AmaRamaa/GearBox-Kosova-2027-VR/version-c-inline-4-improved/print/one-plate-70pct/checks/gear_report.txt

pinion 14T - 42T (x6)      cd  24.89  teeth reach 1.78 mm  tip-root gap 0.22  interference 0.000  backlash 0.40-0.40 mm  teeth in contact 1-2 (avg 1.88)  OK
shifted 14T - 40T (x3)     cd  24.89  teeth reach 1.48 mm  tip-root gap 0.22  interference 0.000  backlash 0.33-0.33 mm  teeth in contact 1-2 (avg 1.46)  OK
ALL GEAR MESHES OK
