AmaRamaa/GearBox-Kosova-2027-VR/version-c-inline-4-improved/print/beds_overview.png

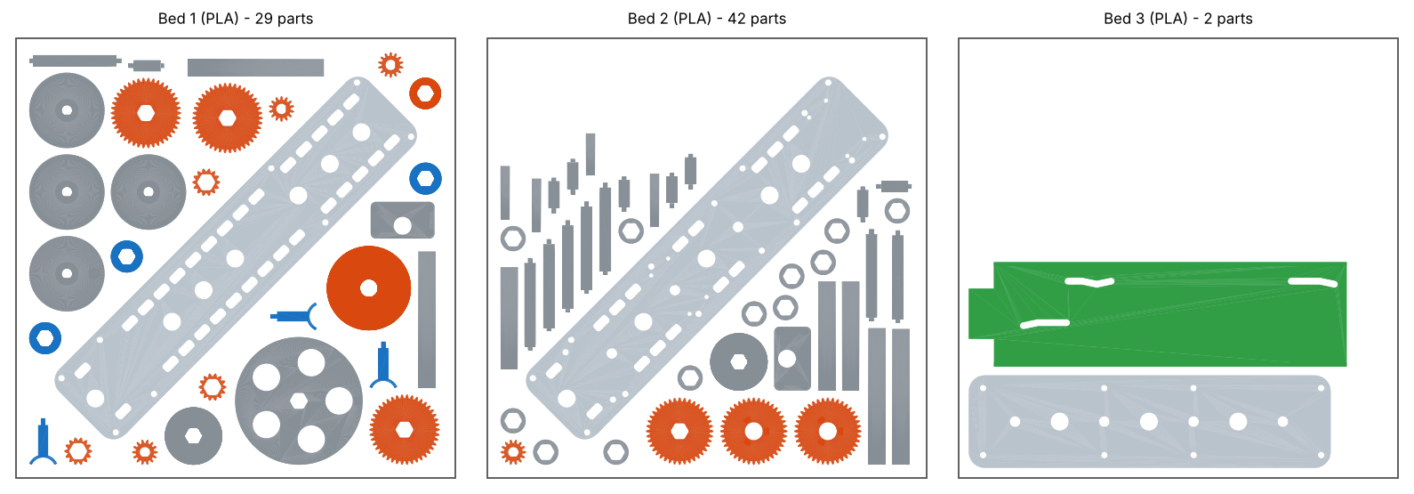
version-c-inline-4-improved/print/beds_overview.png
