AmaRamaa/GearBox-Kosova-2027-VR/version-c-inline-4-improved/print/one-plate-70pct/guide/parts_sheet.png

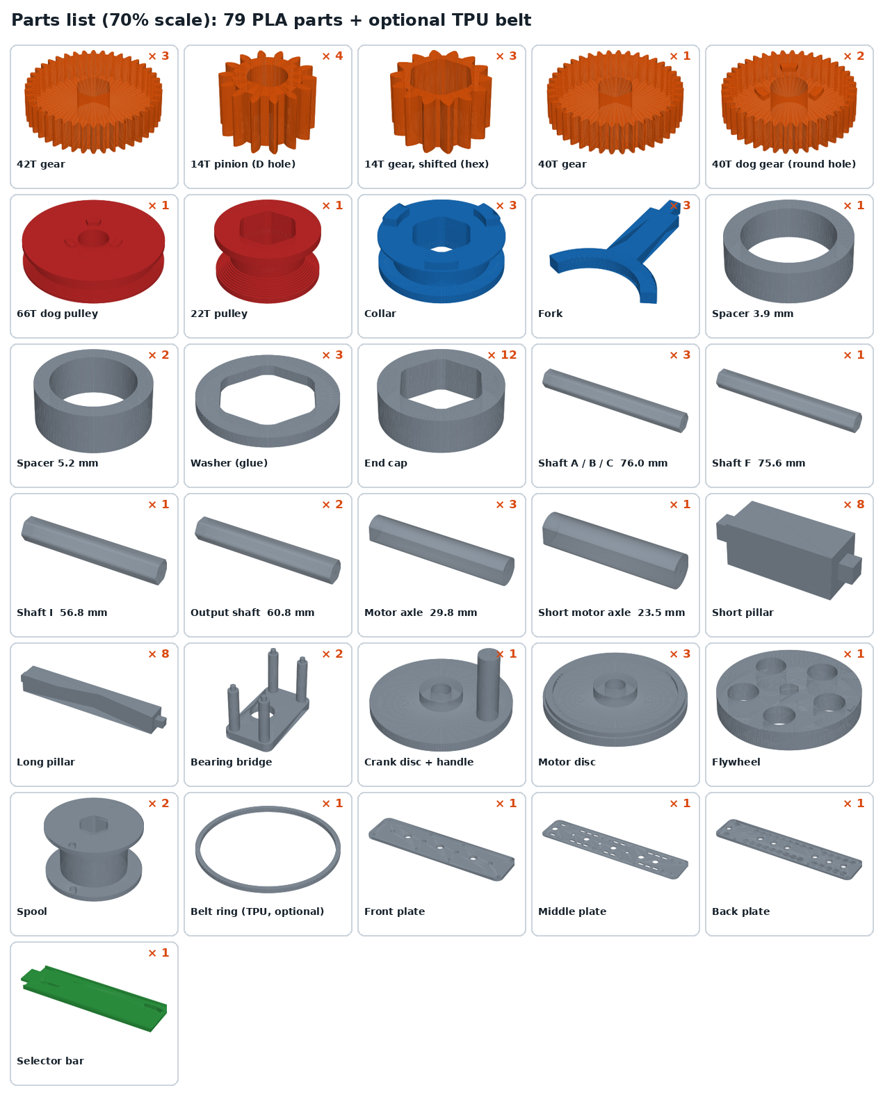
version-c-inline-4-improved/print/one-plate-70pct/guide/parts_sheet.png
