AmaRamaa/GearBox-Kosova-2027-VR/version-c-inline-4-improved/print/bed_TPU_belt.3mf

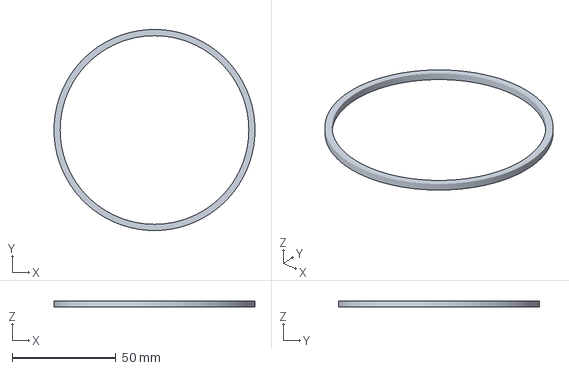
[picture p3: CAD file, 2026-10-18]
version-c-inline-4-improved/print/bed_TPU_belt.3mf
96.7 x 96.7 x 3.00 mm
