AmaRamaa/GearBox-Kosova-2027-VR/version-c-inline-4-improved/print/one-plate-70pct/bed_one_plate_PLA_70pct.3mf

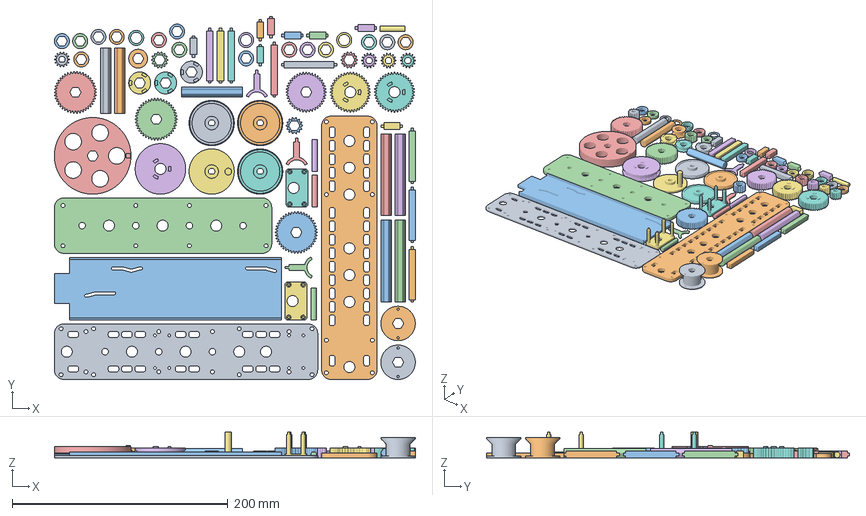
[picture p4: CAD file, 2026-10-18]
version-c-inline-4-improved/print/one-plate-70pct/bed_one_plate_PLA_70pct.3mf
335.3 x 336.9 x 23.8 mm
plate_middle
plate_back
selector_bar
plate_front
flywheel
pulley_66T_dog
crank_disc_handle
crank_disc_1
crank_disc_2
crank_disc_3
gear_42T_1
gear_42T_2
gear_42T_3
gear_40T
gear_40T_dog_1
gear_40T_dog_2
spool_1
spool_2
shaft_ABC_1
shaft_ABC_2
shaft_ABC_3
shaft_F
bridge_1
bridge_2
shaft_O2_O3_1
shaft_O2_O3_2
shaft_I
fork_1
fork_2
fork_3
collar_1
collar_2
collar_3
pillar_back_1
pillar_back_2
pillar_back_3
pillar_back_4
pillar_back_5
pillar_back_6
pillar_back_7
pillar_back_8
pulley_22T
gear_14T_shifted_1
gear_14T_shifted_2
gear_14T_shifted_3
pinion_14T_1
pinion_14T_2
pinion_14T_3
pinion_14T_4
end_cap_1
end_cap_2
end_cap_3
end_cap_4
end_cap_5
end_cap_6
end_cap_7
end_cap_8
end_cap_9
end_cap_10
end_cap_11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
