AmaRamaa/GearBox-Kosova-2027-VR/version-c-inline-4-improved/print/stl/gear_40T_dog.stl

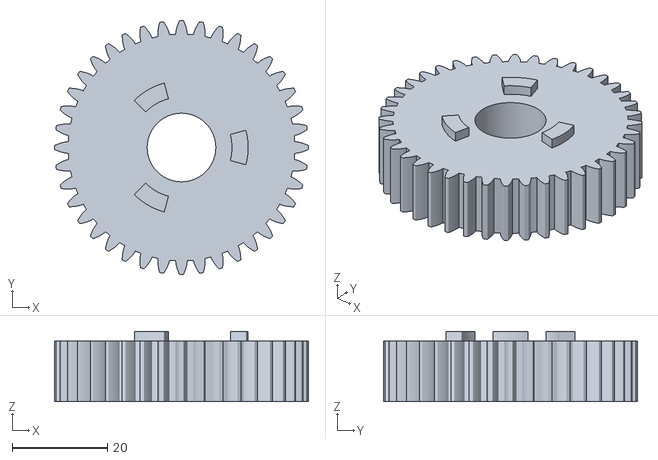
[picture p5: CAD file, 2026-10-18]
version-c-inline-4-improved/print/stl/gear_40T_dog.stl
53.3 x 53.3 x 14.7
