AmaRamaa/GearBox-Kosova-2027-VR/version-c-inline-4-improved/print/bed_2_PLA.3mf

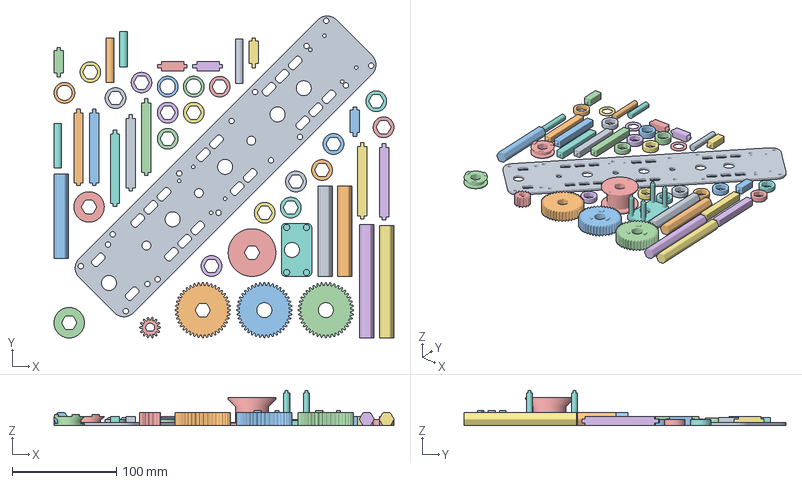
[picture p6: CAD file, 2026-10-18]
version-c-inline-4-improved/print/bed_2_PLA.3mf
326.0 x 308.7 x 33.9 mm
plate_middle
gear_40T
gear_40T_dog_1
gear_40T_dog_2
spool_2
shaft_ABC_3
shaft_F
bridge_2
shaft_O2_O3_1
shaft_O2_O3_2
shaft_I
collar_2
collar_3
pillar_back_2
pillar_back_3
pillar_back_4
pillar_back_5
pillar_back_6
pillar_back_7
pillar_back_8
pinion_14T_4
end_cap_1
end_cap_2
end_cap_3
end_cap_4
end_cap_5
end_cap_6
end_cap_7
end_cap_8
end_cap_9
end_cap_10
end_cap_11
end_cap_12
spacer_A
spacer_O2_O3_1
spacer_O2_O3_2
washer_1
washer_2
washer_3
axle_M1_M3_1
axle_M1_M3_2
axle_M1_M3_3
pillar_front_4
pillar_front_5
pillar_front_6
pillar_front_7
pillar_front_8
axle_M4
