AmaRamaa/GearBox-Kosova-2027-VR/version-c-inline-4-improved/print/one-plate-70pct/bed_TPU_belt_70pct.3mf

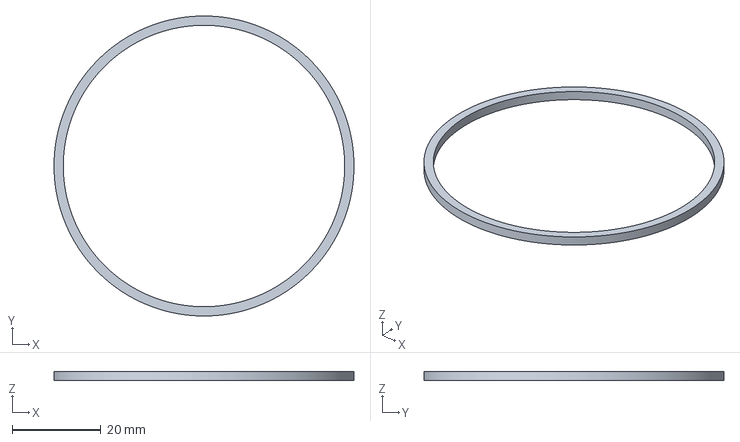
[picture p7: CAD file, 2026-10-18]
version-c-inline-4-improved/print/one-plate-70pct/bed_TPU_belt_70pct.3mf
67.7 x 67.7 x 2.10 mm
