AmaRamaa/GearBox-Kosova-2027-VR/version-c-inline-4-improved/print/one-plate-70pct/stl/selector_bar.stl

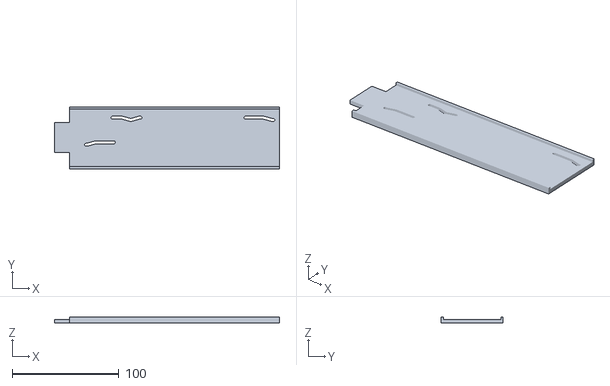
[picture p8: CAD file, 2026-10-18]
version-c-inline-4-improved/print/one-plate-70pct/stl/selector_bar.stl
210.7 x 58.1 x 5.60
