AmaRamaa/GearBox-Kosova-2027-VR/version-c-inline-4-improved/print/stl/pulley_66T_dog.stl

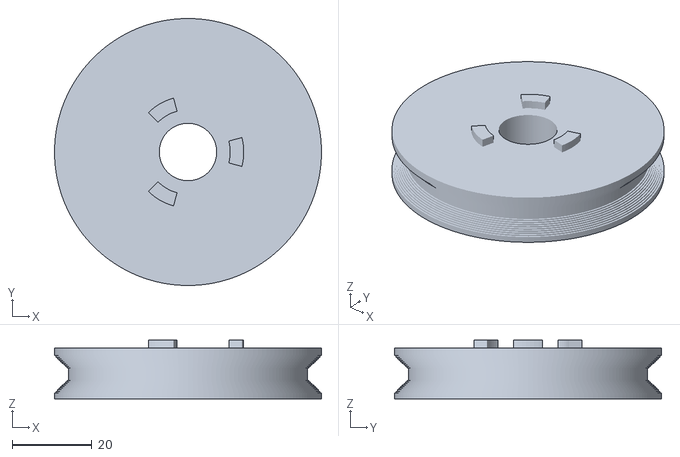
[picture p9: CAD file, 2026-10-18]
version-c-inline-4-improved/print/stl/pulley_66T_dog.stl
67.0 x 67.0 x 14.7
