AmaRamaa/GearBox-Kosova-2027-VR/version-c-inline-4-improved/print/bed_3_PLA.3mf

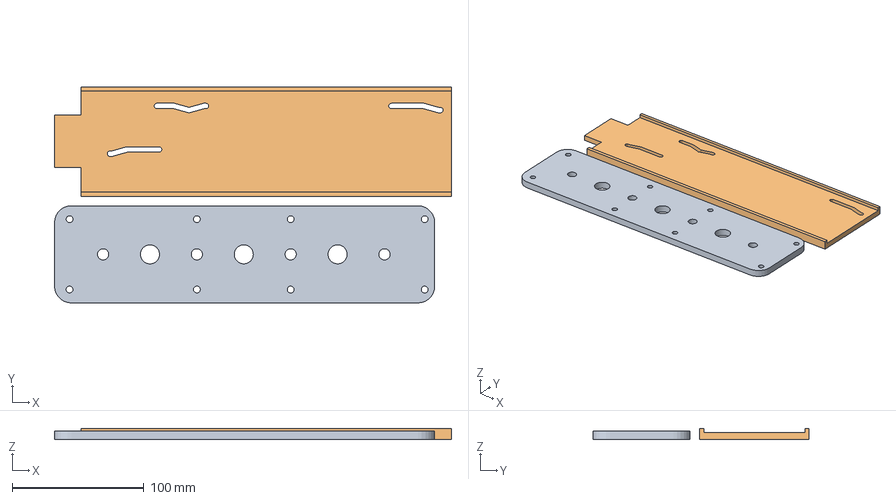
[picture p10: CAD file, 2026-10-18]
version-c-inline-4-improved/print/bed_3_PLA.3mf
301.0 x 163.7 x 8.00 mm
plate_front
selector_bar
