AmaRamaa/GearBox-Kosova-2027-VR/version-c-inline-4-improved/print/one-plate-70pct/stl/collar.stl

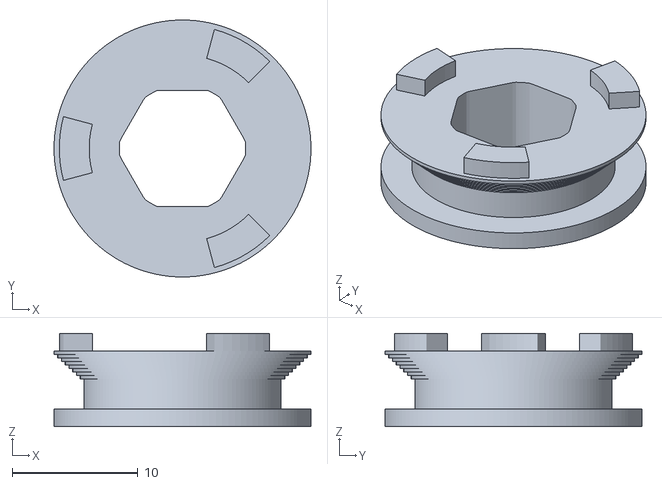
[picture p11: CAD file, 2026-10-18]
version-c-inline-4-improved/print/one-plate-70pct/stl/collar.stl
20.4 x 20.4 x 7.42
