AmaRamaa/GearBox-Kosova-2027-VR/version-c-inline-4-improved/print/stl/plate_middle.stl

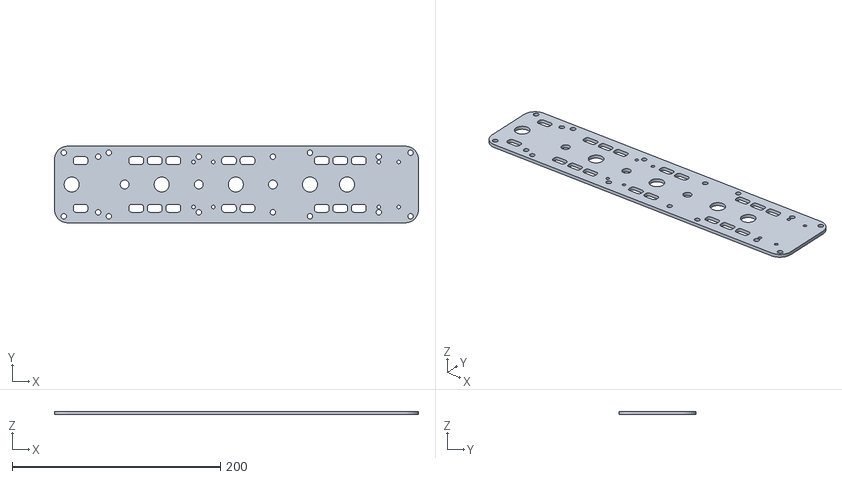
[picture p12: CAD file, 2026-10-18]
version-c-inline-4-improved/print/stl/plate_middle.stl
349.2 x 73.7 x 3.17
