AmaRamaa/GearBox-Kosova-2027-VR/version-c-inline-4-improved/print/bed_1_PLA.3mf

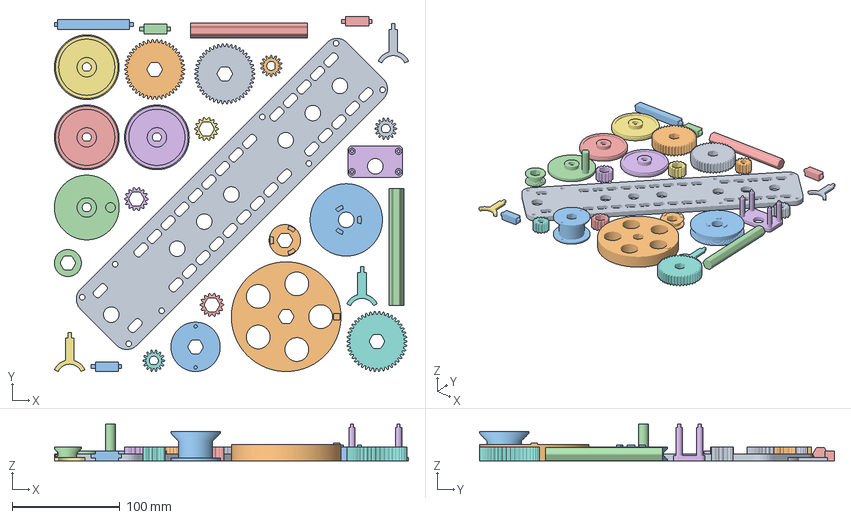
[picture p13: CAD file, 2026-10-18]
version-c-inline-4-improved/print/bed_1_PLA.3mf
328.3 x 329.0 x 34.0 mm
plate_back
flywheel
pulley_66T_dog
crank_disc_handle
crank_disc_1
crank_disc_2
crank_disc_3
gear_42T_1
gear_42T_2
gear_42T_3
spool_1
shaft_ABC_1
shaft_ABC_2
bridge_1
fork_1
fork_2
fork_3
collar_1
pillar_back_1
pulley_22T
gear_14T_shifted_1
gear_14T_shifted_2
gear_14T_shifted_3
pinion_14T_1
pinion_14T_2
pinion_14T_3
pillar_front_1
pillar_front_2
pillar_front_3
