AmaRamaa/GearBox-Kosova-2027-VR/version-c-inline-4-improved/print/one-plate-70pct/stl/pulley_66T_dog.stl

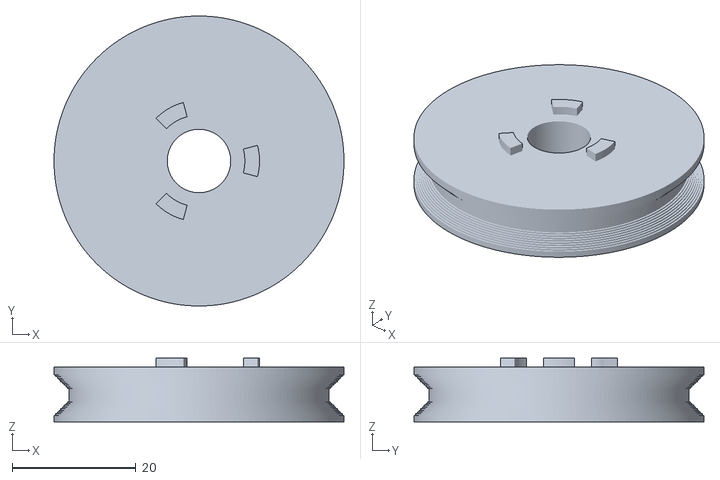
[picture p14: CAD file, 2026-10-18]
version-c-inline-4-improved/print/one-plate-70pct/stl/pulley_66T_dog.stl
46.9 x 46.9 x 10.3
