AmaRamaa/GearBox-Kosova-2027-VR/version-c-inline-4-improved/print/stl/plate_front.stl

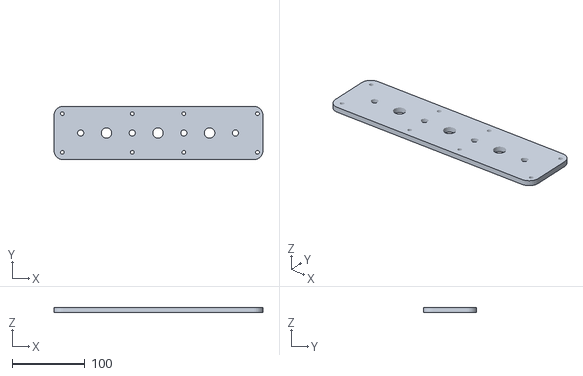
[picture p16: CAD file, 2026-10-18]
version-c-inline-4-improved/print/stl/plate_front.stl
288.3 x 73.7 x 6.35
