AmaRamaa/GearBox-Kosova-2027-VR/version-c-inline-4-improved/print/one-plate-70pct/stl/fork.stl

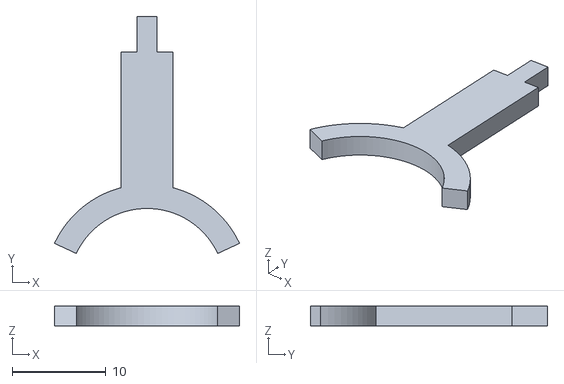
[picture p17: CAD file, 2026-10-18]
version-c-inline-4-improved/print/one-plate-70pct/stl/fork.stl
19.8 x 25.3 x 2.13
