AmaRamaa/GearBox-Kosova-2027-VR/version-c-inline-4-improved/print/stl/plate_back.stl

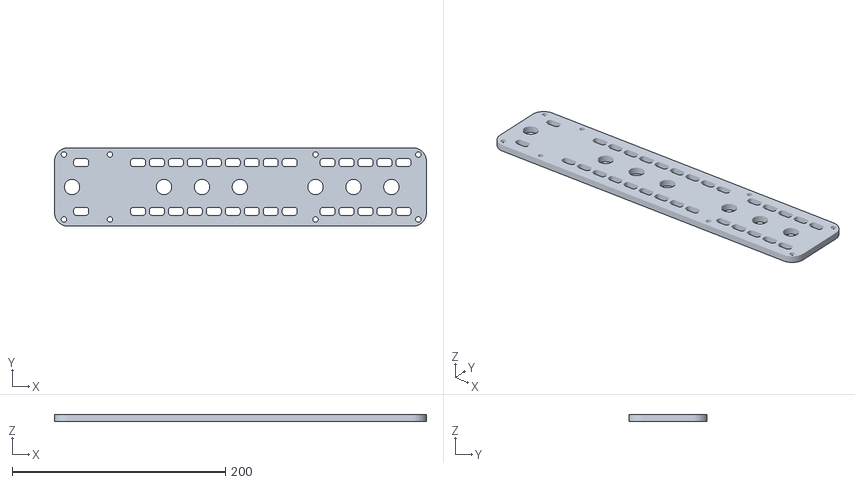
[picture p18: CAD file, 2026-10-18]
version-c-inline-4-improved/print/stl/plate_back.stl
349.2 x 73.7 x 6.35
