AmaRamaa/GearBox-Kosova-2027-VR/version-c-inline-4-improved/print/one-plate-70pct/stl/crank_disc_handle.stl

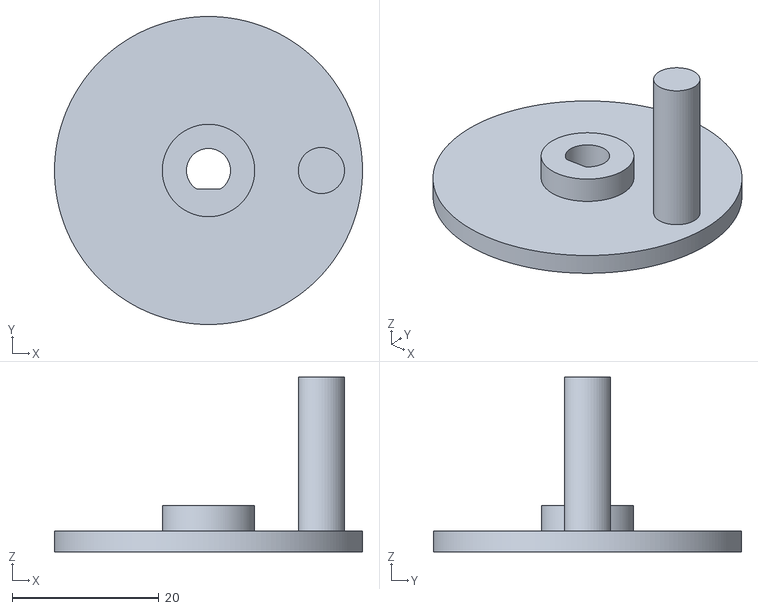
[picture p19: CAD file, 2026-10-18]
version-c-inline-4-improved/print/one-plate-70pct/stl/crank_disc_handle.stl
42.0 x 42.0 x 23.8
