AmaRamaa/GearBox-Kosova-2027-VR/version-c-inline-4-improved/print/stl/fork.stl

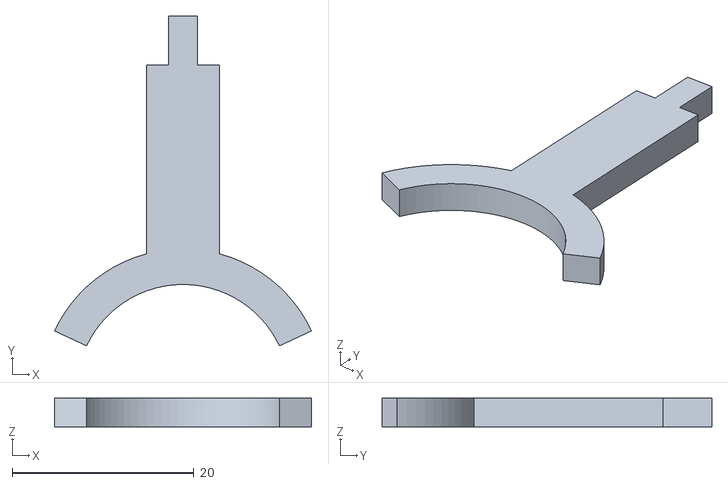
[picture p20: CAD file, 2026-10-18]
version-c-inline-4-improved/print/stl/fork.stl
28.3 x 36.3 x 3.15
