AmaRamaa/GearBox-Kosova-2027-VR/version-c-inline-4-improved/print/stl/selector_bar.stl

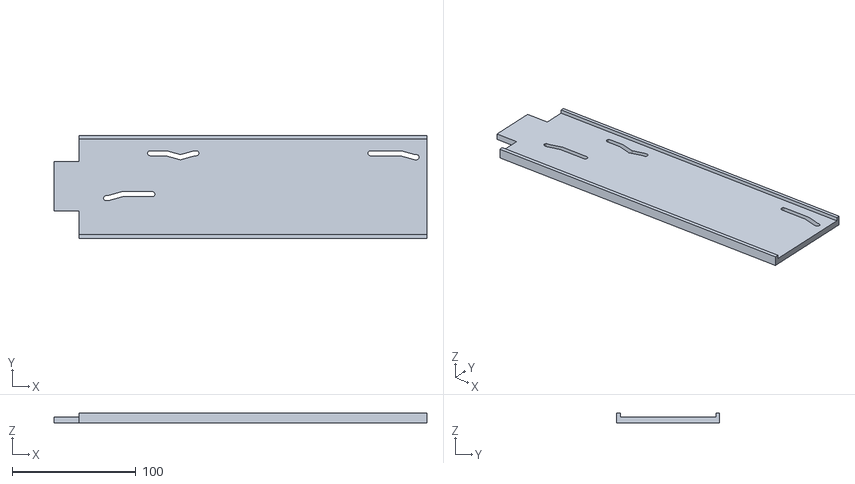
[picture p21: CAD file, 2026-10-18]
version-c-inline-4-improved/print/stl/selector_bar.stl
301.0 x 83.0 x 8.00
