AmaRamaa/GearBox-Kosova-2027-VR/version-c-inline-4-improved/print/one-plate-70pct/stl/shaft_ABC.stl

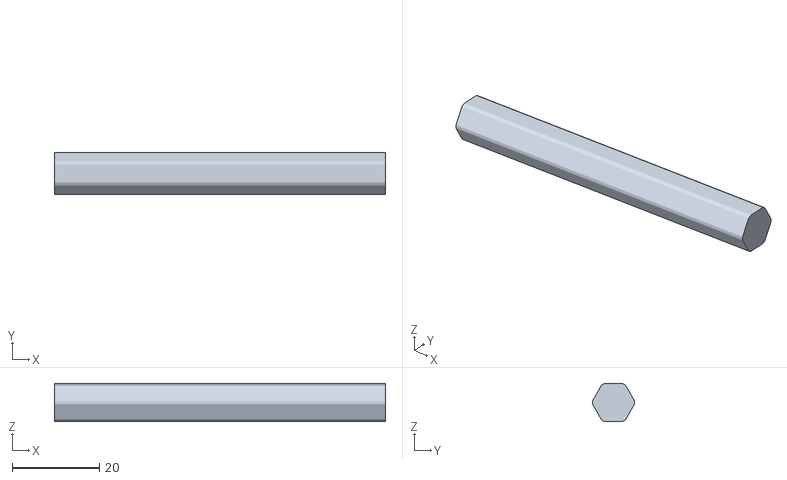
[picture p22: CAD file, 2026-10-18]
version-c-inline-4-improved/print/one-plate-70pct/stl/shaft_ABC.stl
76.0 x 9.66 x 8.75
