AmaRamaa/GearBox-Kosova-2027-VR/version-c-inline-4-improved/print/stl/collar.stl

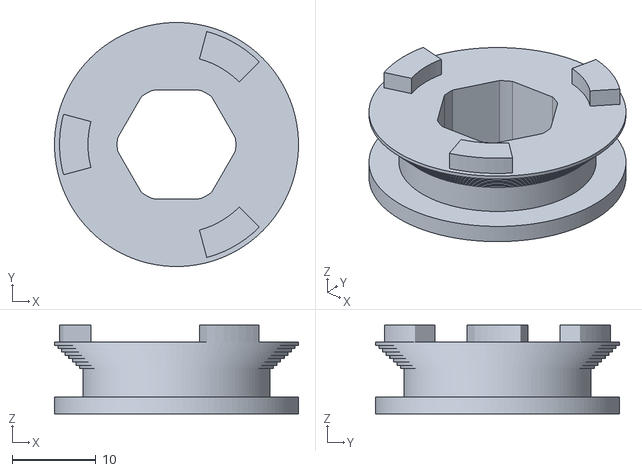
[picture p23: CAD file, 2026-10-18]
version-c-inline-4-improved/print/stl/collar.stl
29.2 x 29.2 x 10.6
