AmaRamaa/GearBox-Kosova-2027-VR/version-c-inline-4-improved/print/one-plate-70pct/stl/gear_40T.stl

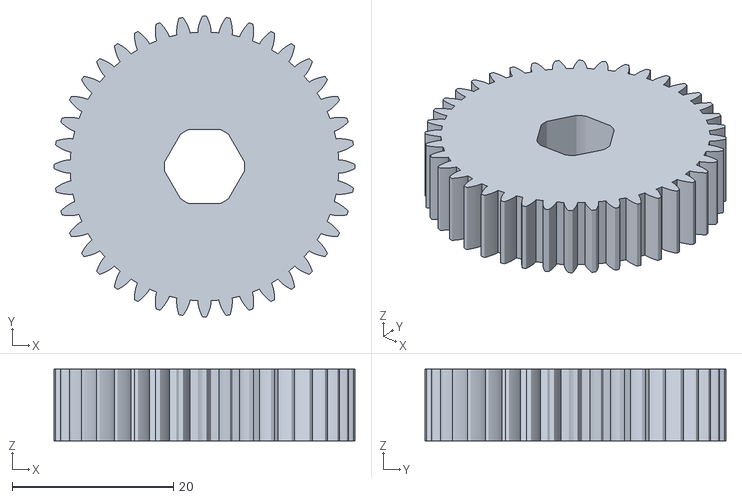
[picture p24: CAD file, 2026-10-18]
version-c-inline-4-improved/print/one-plate-70pct/stl/gear_40T.stl
37.3 x 37.3 x 8.89
