AmaRamaa/GearBox-Kosova-2027-VR/version-c-inline-4-improved/print/stl/gear_40T.stl

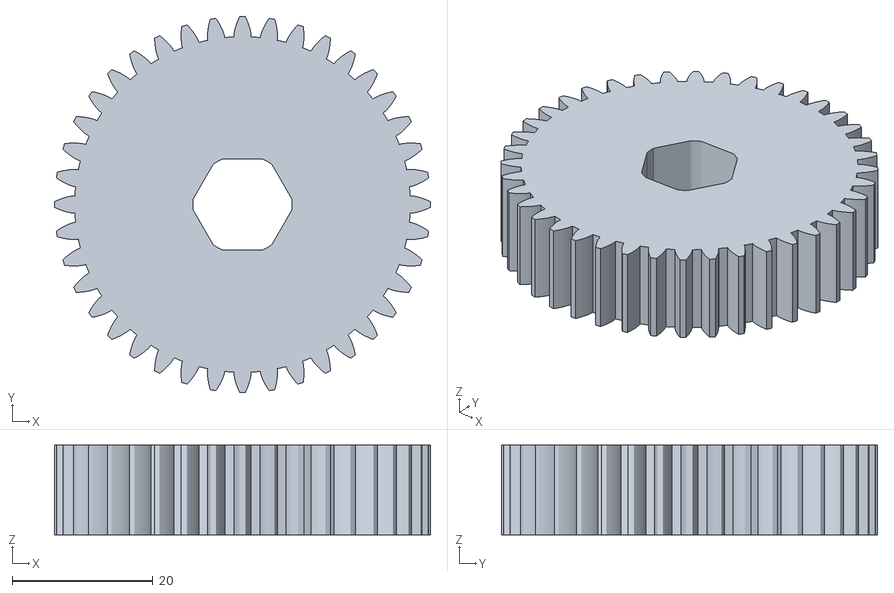
[picture p25: CAD file, 2026-10-18]
version-c-inline-4-improved/print/stl/gear_40T.stl
53.3 x 53.3 x 12.7
