AmaRamaa/GearBox-Kosova-2027-VR/version-c-inline-4-improved/print/one-plate-70pct/stl/spacer_A.stl

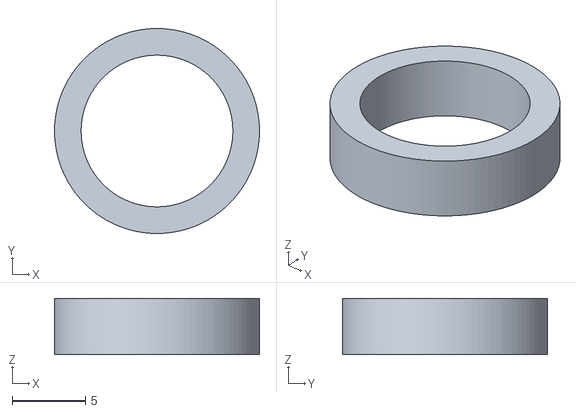
[picture p26: CAD file, 2026-10-18]
version-c-inline-4-improved/print/one-plate-70pct/stl/spacer_A.stl
14.0 x 14.0 x 3.85
