AmaRamaa/GearBox-Kosova-2027-VR/version-c-inline-4-improved/print/stl/shaft_O2_O3.stl

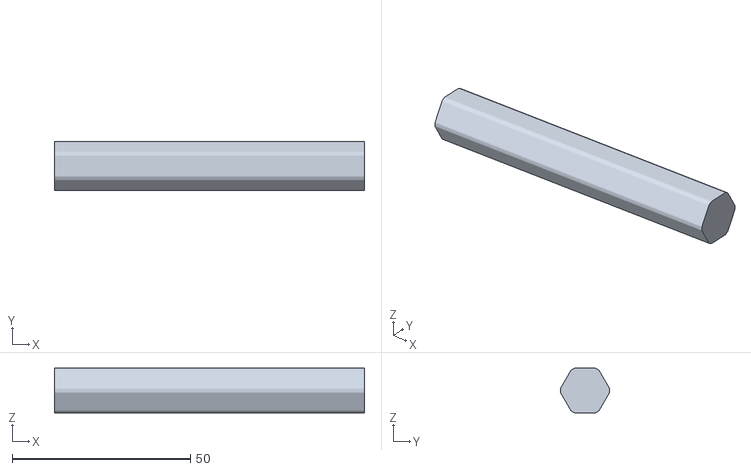
[picture p27: CAD file, 2026-10-17]
version-c-inline-4-improved/print/stl/shaft_O2_O3.stl
86.9 x 13.8 x 12.5
