AmaRamaa/GearBox-Kosova-2027-VR/version-c-inline-4-improved/print/one-plate-70pct/stl/gear_42T.stl

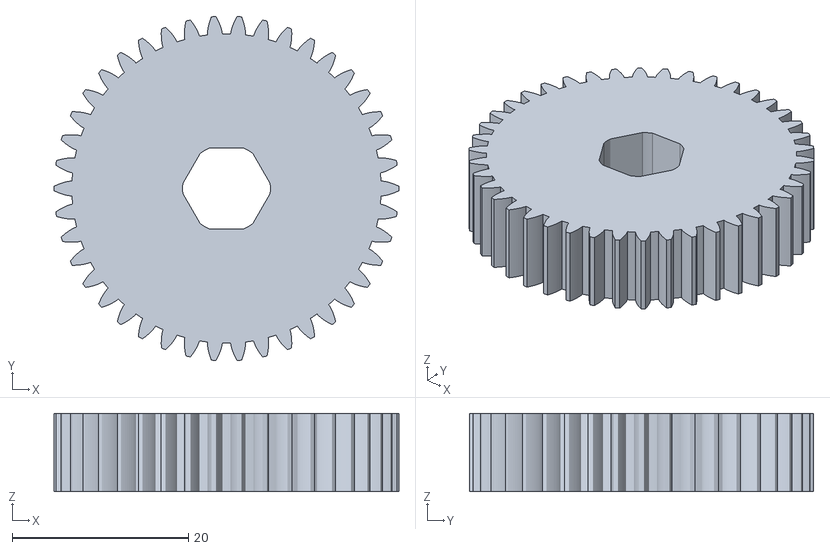
[picture p28: CAD file, 2026-10-18]
version-c-inline-4-improved/print/one-plate-70pct/stl/gear_42T.stl
39.1 x 39.0 x 8.89
