AmaRamaa/GearBox-Kosova-2027-VR/version-c-inline-4-improved/print/stl/crank_disc.stl

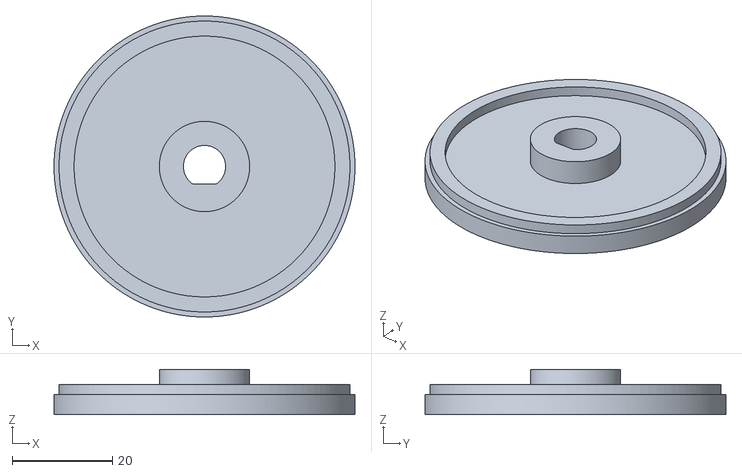
[picture p29: CAD file, 2026-10-17]
version-c-inline-4-improved/print/stl/crank_disc.stl
60.0 x 60.0 x 9.00
