AmaRamaa/GearBox-Kosova-2027-VR/version-c-inline-4-improved/print/one-plate-70pct/stl/shaft_I.stl

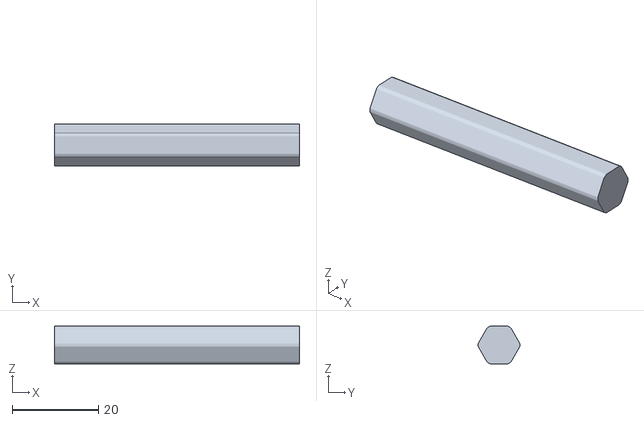
[picture p30: CAD file, 2026-10-18]
version-c-inline-4-improved/print/one-plate-70pct/stl/shaft_I.stl
56.8 x 9.66 x 8.75
