AmaRamaa/GearBox-Kosova-2027-VR/version-c-inline-4-improved/print/stl/gear_42T.stl

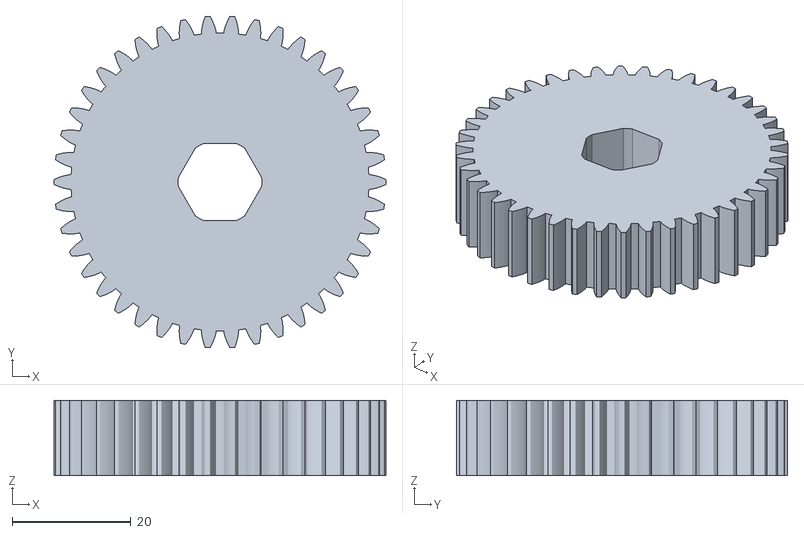
[picture p31: CAD file, 2026-10-17]
version-c-inline-4-improved/print/stl/gear_42T.stl
55.9 x 55.8 x 12.7
