AmaRamaa/GearBox-Kosova-2027-VR/version-c-inline-4-improved/print/one-plate-70pct/stl/axle_M4.stl

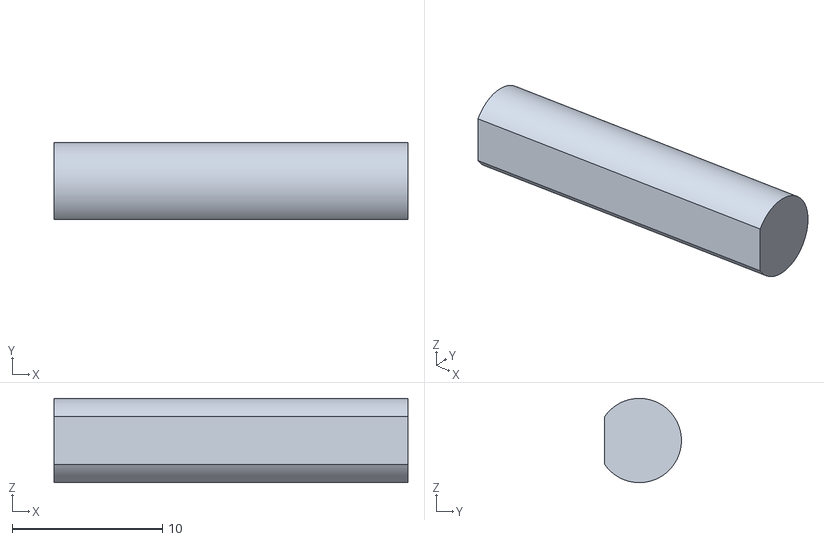
[picture p32: CAD file, 2026-10-18]
version-c-inline-4-improved/print/one-plate-70pct/stl/axle_M4.stl
23.5 x 5.11 x 5.60
