AmaRamaa/GearBox-Kosova-2027-VR/version-c-inline-4-improved/print/stl/pillar_back.stl

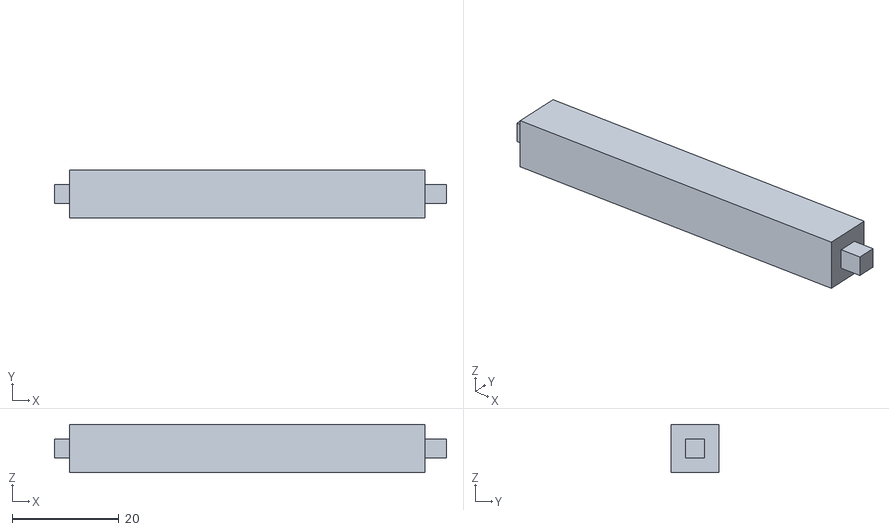
[picture p33: CAD file, 2026-10-17]
version-c-inline-4-improved/print/stl/pillar_back.stl
73.5 x 9.00 x 9.00
