AmaRamaa/GearBox-Kosova-2027-VR/version-c-inline-4-improved/print/one-plate-70pct/stl/crank_disc.stl

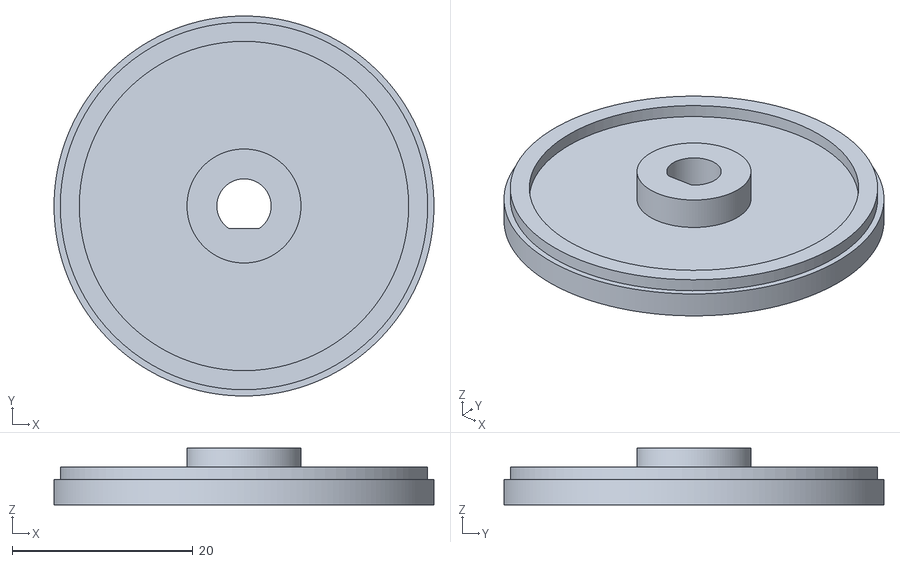
[picture p34: CAD file, 2026-10-18]
version-c-inline-4-improved/print/one-plate-70pct/stl/crank_disc.stl
42.0 x 42.0 x 6.30
