AmaRamaa/GearBox-Kosova-2027-VR/version-c-inline-4-improved/print/stl/axle_M1_M3.stl

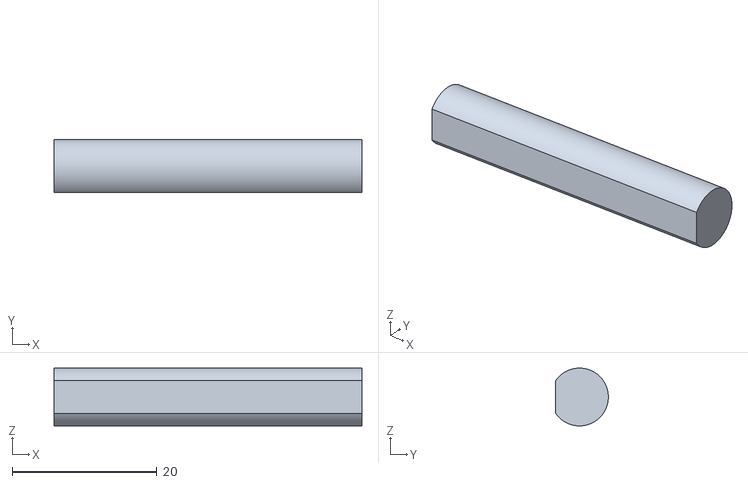
[picture p35: CAD file, 2026-10-17]
version-c-inline-4-improved/print/stl/axle_M1_M3.stl
42.6 x 7.30 x 8.00
