AmaRamaa/GearBox-Kosova-2027-VR/version-c-inline-4-improved/print/stl/spacer_A.stl

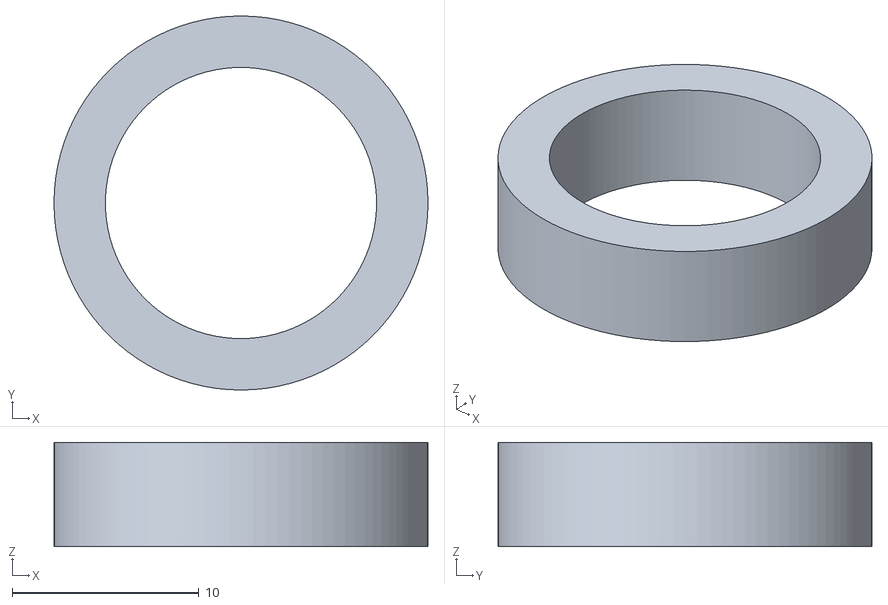
[picture p37: CAD file, 2026-10-17]
version-c-inline-4-improved/print/stl/spacer_A.stl
20.0 x 20.0 x 5.57
