AmaRamaa/GearBox-Kosova-2027-VR/version-c-inline-4-improved/print/one-plate-70pct/stl/pulley_22T.stl

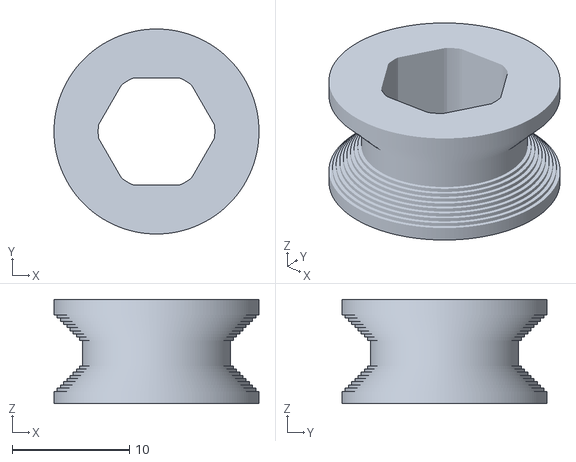
[picture p38: CAD file, 2026-10-18]
version-c-inline-4-improved/print/one-plate-70pct/stl/pulley_22T.stl
17.5 x 17.5 x 8.89
