AmaRamaa/GearBox-Kosova-2027-VR/version-c-inline-4-improved/print/stl/crank_disc_handle.stl

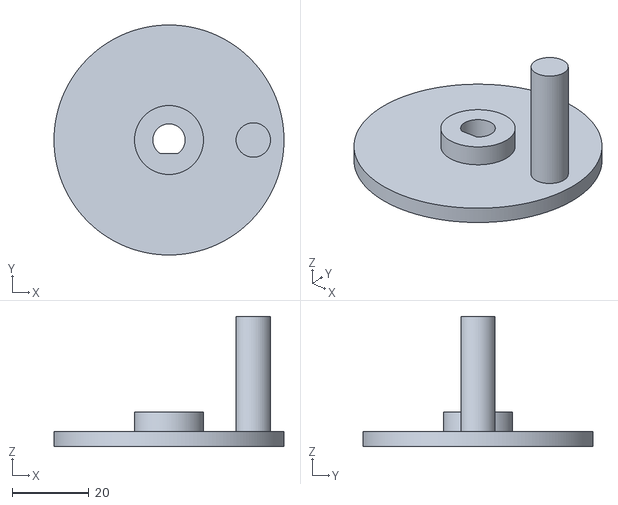
[picture p39: CAD file, 2026-10-17]
version-c-inline-4-improved/print/stl/crank_disc_handle.stl
60.0 x 60.0 x 34.0
