AmaRamaa/GearBox-Kosova-2027-VR/version-c-inline-4-improved/print/one-plate-70pct/stl/axle_M1_M3.stl

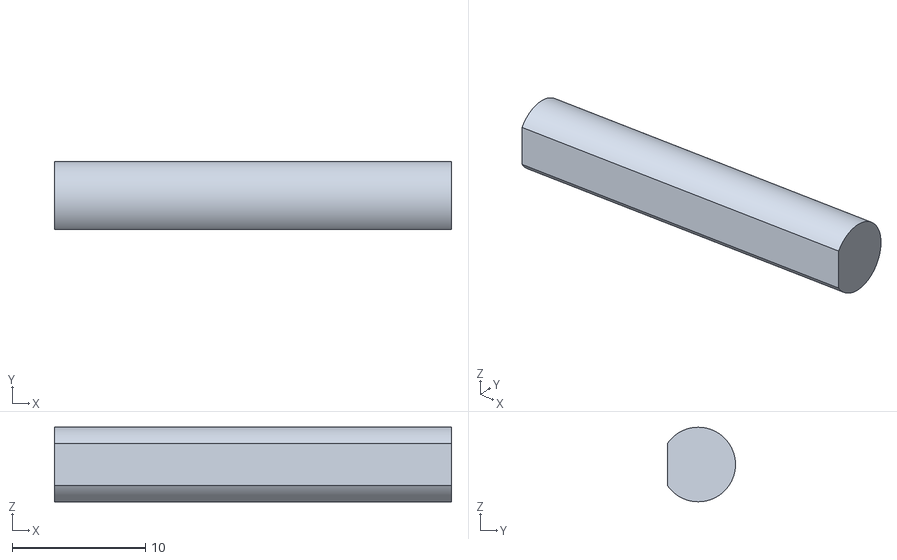
[picture p40: CAD file, 2026-10-18]
version-c-inline-4-improved/print/one-plate-70pct/stl/axle_M1_M3.stl
29.8 x 5.11 x 5.60
