AmaRamaa/GearBox-Kosova-2027-VR/version-c-inline-4-improved/print/stl/end_cap.stl

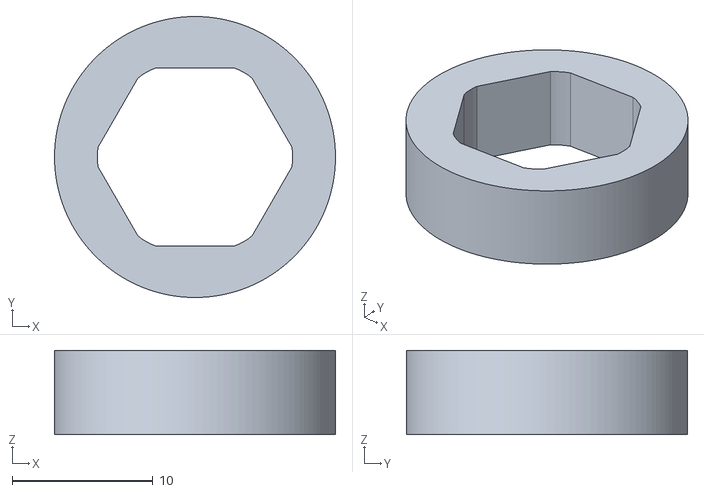
[picture p41: CAD file, 2026-10-17]
version-c-inline-4-improved/print/stl/end_cap.stl
20.0 x 20.0 x 6.00
