AmaRamaa/GearBox-Kosova-2027-VR/version-c-inline-4-improved/print/one-plate-70pct/stl/pinion_14T.stl

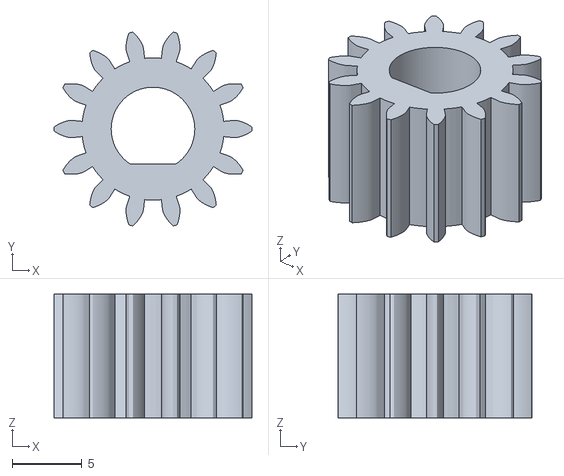
[picture p42: CAD file, 2026-10-18]
version-c-inline-4-improved/print/one-plate-70pct/stl/pinion_14T.stl
14.2 x 13.9 x 8.89
