AmaRamaa/GearBox-Kosova-2027-VR/version-c-inline-4-improved/print/stl/shaft_F.stl

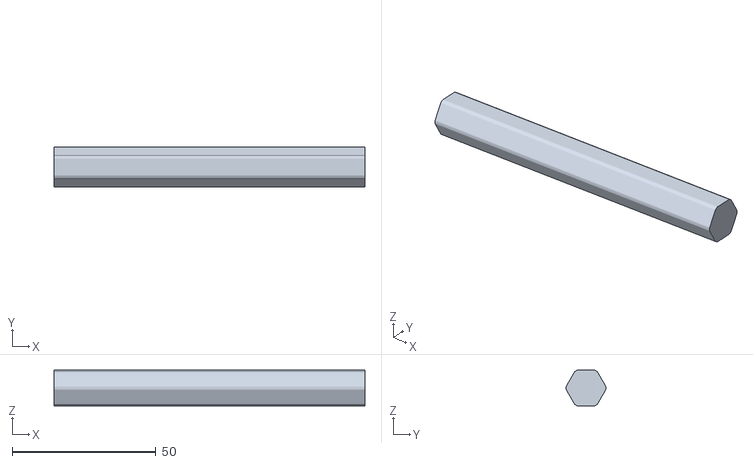
[picture p43: CAD file, 2026-10-17]
version-c-inline-4-improved/print/stl/shaft_F.stl
108.0 x 13.8 x 12.5
