AmaRamaa/GearBox-Kosova-2027-VR/version-c-inline-4-improved/print/one-plate-70pct/stl/bridge.stl

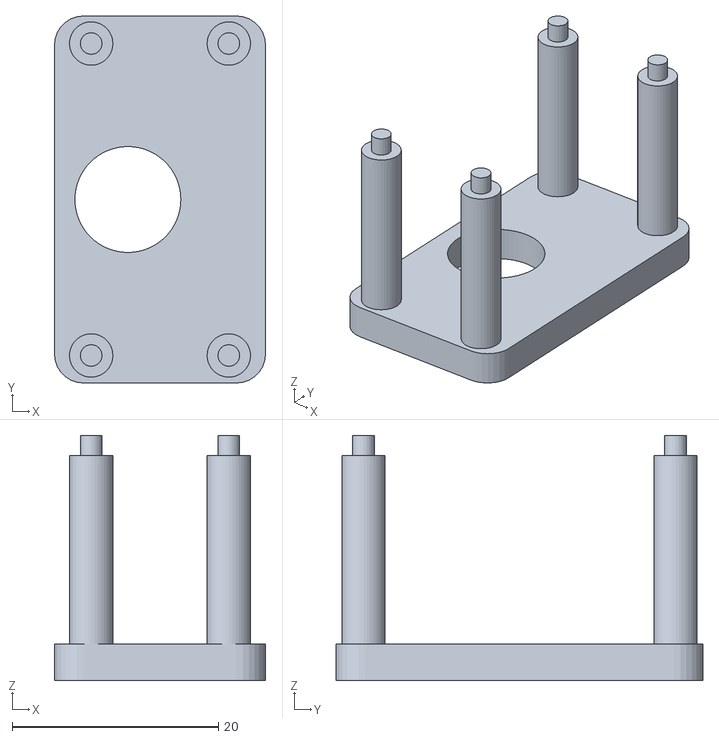
[picture p44: CAD file, 2026-10-18]
version-c-inline-4-improved/print/one-plate-70pct/stl/bridge.stl
20.4 x 35.6 x 23.7
