AmaRamaa/GearBox-Kosova-2027-VR/version-c-inline-4-improved/print/stl/shaft_I.stl

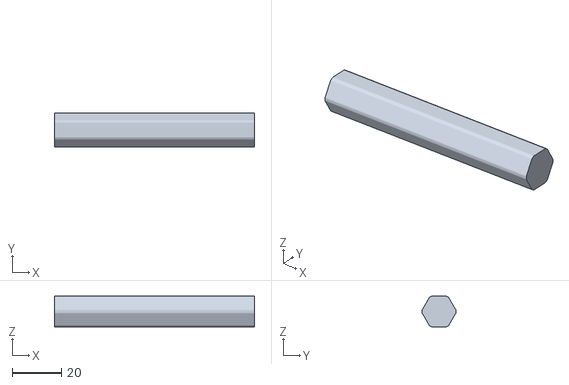
[picture p45: CAD file, 2026-10-17]
version-c-inline-4-improved/print/stl/shaft_I.stl
81.2 x 13.8 x 12.5
