AmaRamaa/GearBox-Kosova-2027-VR/version-c-inline-4-improved/print/one-plate-70pct/stl/gear_14T_shifted.stl

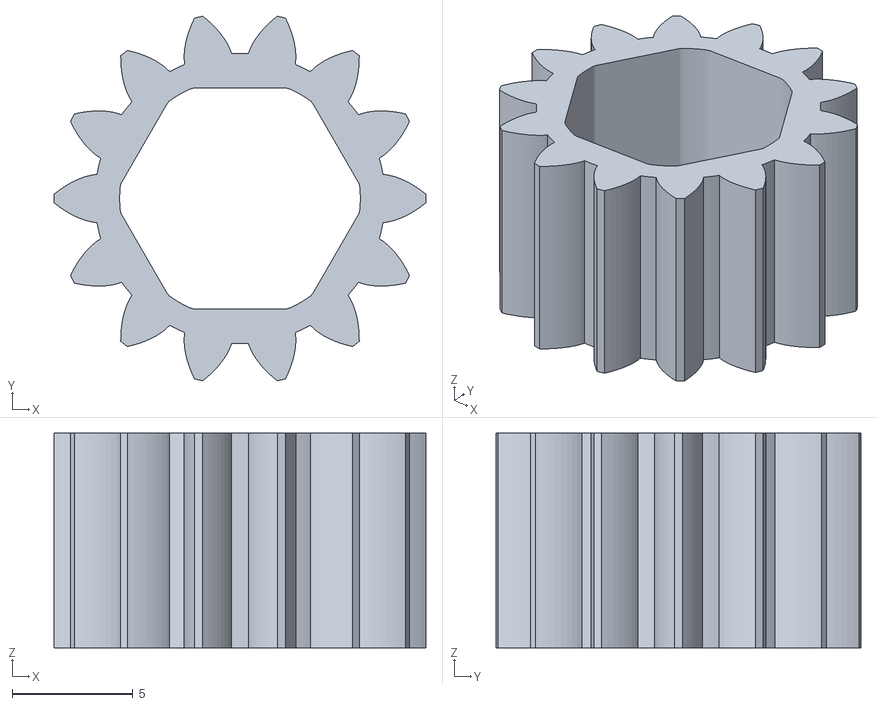
[picture p46: CAD file, 2026-10-18]
version-c-inline-4-improved/print/one-plate-70pct/stl/gear_14T_shifted.stl
15.4 x 15.1 x 8.89
