AmaRamaa/GearBox-Kosova-2027-VR/version-c-inline-4-improved/print/stl/pillar_front.stl

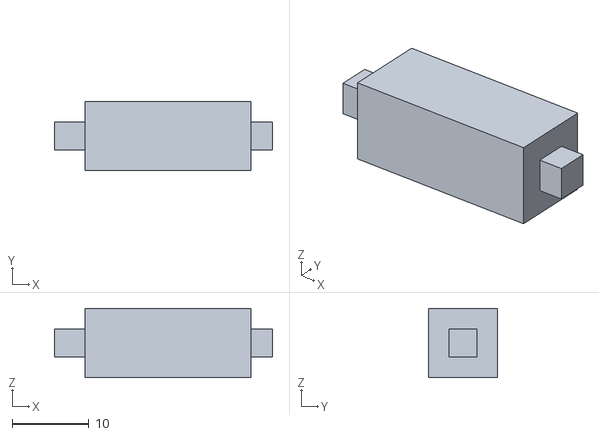
[picture p47: CAD file, 2026-10-17]
version-c-inline-4-improved/print/stl/pillar_front.stl
28.4 x 9.00 x 9.00
