AmaRamaa/GearBox-Kosova-2027-VR/version-c-inline-4-improved/print/one-plate-70pct/stl/pillar_front.stl

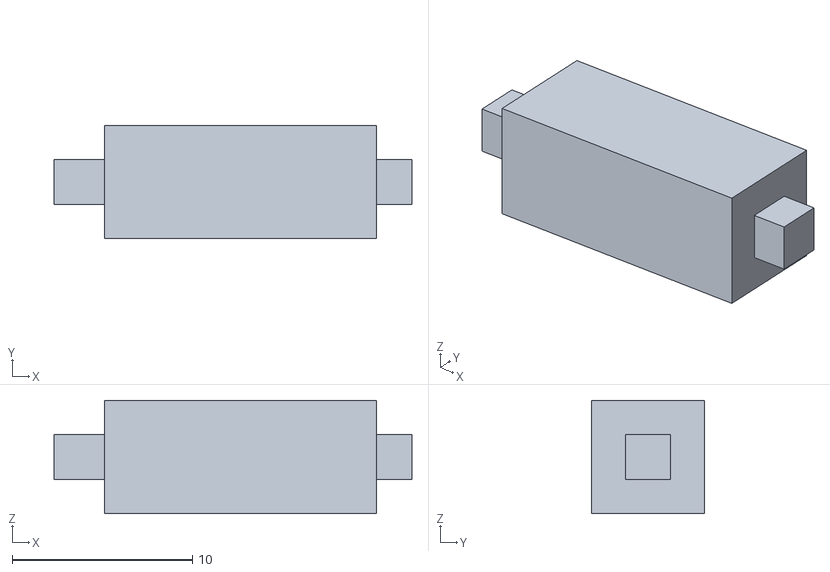
[picture p48: CAD file, 2026-10-18]
version-c-inline-4-improved/print/one-plate-70pct/stl/pillar_front.stl
19.9 x 6.30 x 6.30
