AmaRamaa/GearBox-Kosova-2027-VR/version-c-inline-4-improved/print/stl/gear_14T_shifted.stl

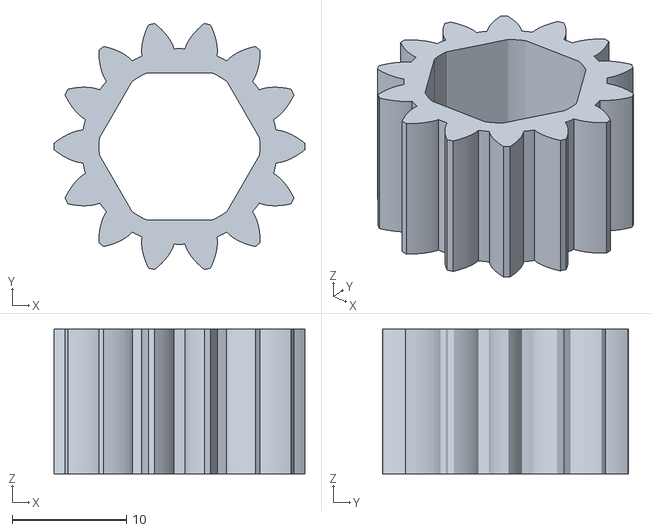
[picture p49: CAD file, 2026-10-17]
version-c-inline-4-improved/print/stl/gear_14T_shifted.stl
22.0 x 21.6 x 12.7
