AmaRamaa/GearBox-Kosova-2027-VR/version-c-inline-4-improved/print/one-plate-70pct/stl/end_cap.stl

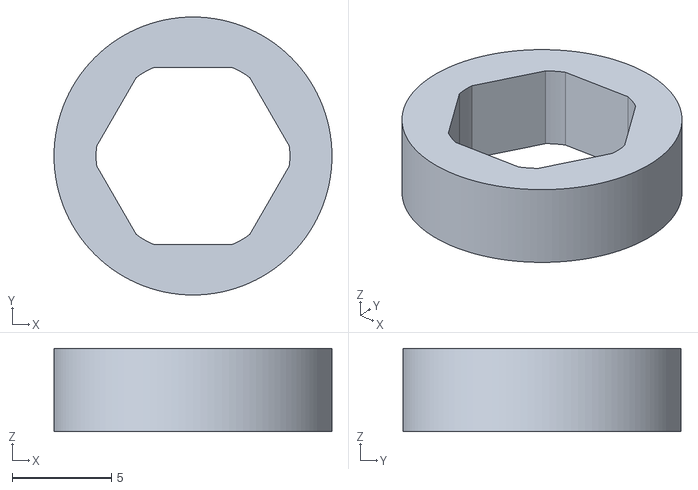
[picture p51: CAD file, 2026-10-18]
version-c-inline-4-improved/print/one-plate-70pct/stl/end_cap.stl
14.0 x 14.0 x 4.20
