AmaRamaa/GearBox-Kosova-2027-VR/version-c-inline-4-improved/print/stl/spool.stl

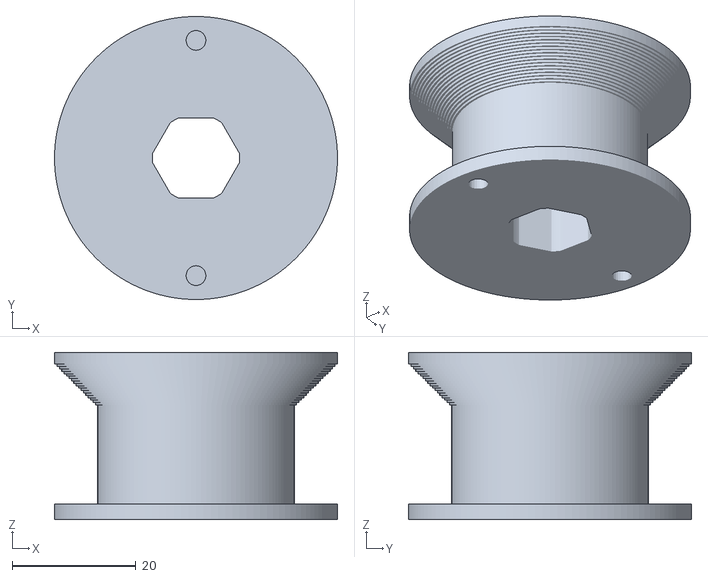
[picture p52: CAD file, 2026-10-17]
version-c-inline-4-improved/print/stl/spool.stl
45.7 x 45.7 x 27.0
