AmaRamaa/GearBox-Kosova-2027-VR/version-c-inline-4-improved/print/one-plate-70pct/stl/spacer_O2_O3.stl

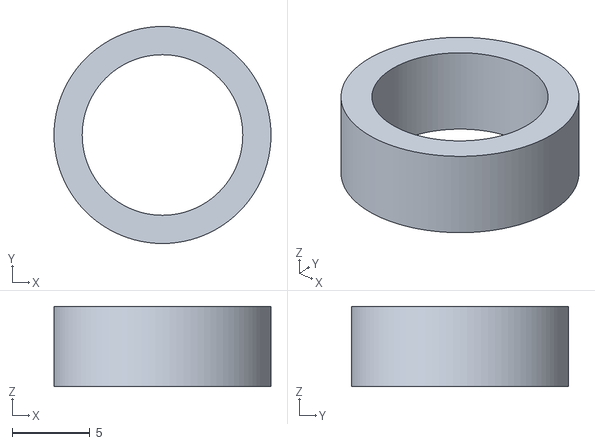
[picture p53: CAD file, 2026-10-18]
version-c-inline-4-improved/print/one-plate-70pct/stl/spacer_O2_O3.stl
14.0 x 14.0 x 5.18
