AmaRamaa/GearBox-Kosova-2027-VR/version-c-inline-4-improved/print/stl/pulley_22T.stl

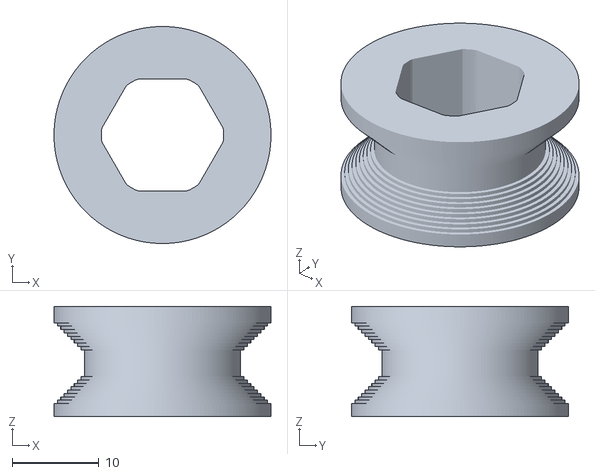
[picture p54: CAD file, 2026-10-17]
version-c-inline-4-improved/print/stl/pulley_22T.stl
25.0 x 25.0 x 12.7
