AmaRamaa/GearBox-Kosova-2027-VR/version-c-inline-4-improved/print/one-plate-70pct/stl/spool.stl

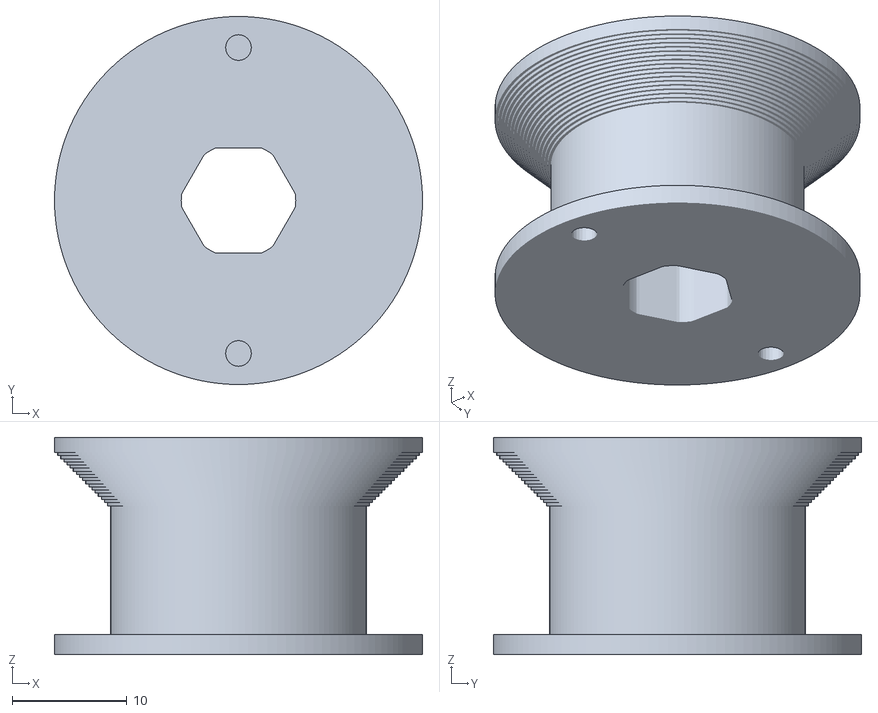
[picture p55: CAD file, 2026-10-18]
version-c-inline-4-improved/print/one-plate-70pct/stl/spool.stl
32.0 x 32.0 x 18.9
