AmaRamaa/GearBox-Kosova-2027-VR/version-c-inline-4-improved/print/stl/axle_M4.stl

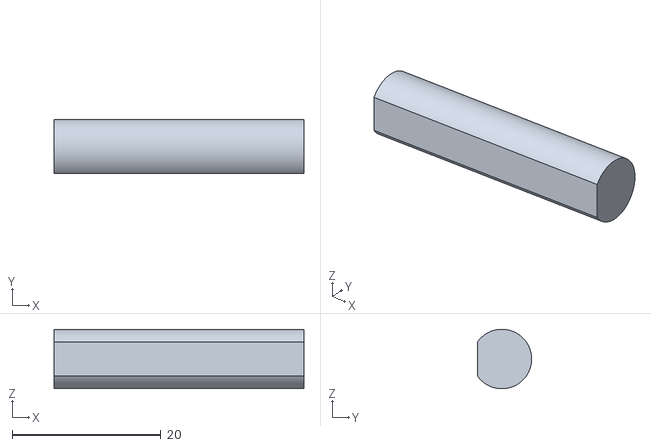
[picture p56: CAD file, 2026-10-17]
version-c-inline-4-improved/print/stl/axle_M4.stl
33.6 x 7.30 x 8.00
