AmaRamaa/GearBox-Kosova-2027-VR/version-c-inline-4-improved/print/one-plate-70pct/stl/plate_back.stl

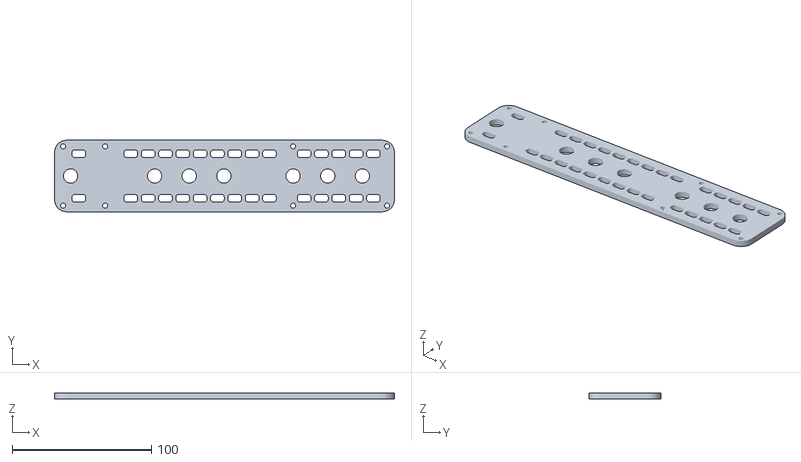
[picture p57: CAD file, 2026-10-18]
version-c-inline-4-improved/print/one-plate-70pct/stl/plate_back.stl
244.5 x 51.6 x 4.45
