AmaRamaa/GearBox-Kosova-2027-VR/version-c-inline-4-improved/print/stl/spacer_O2_O3.stl

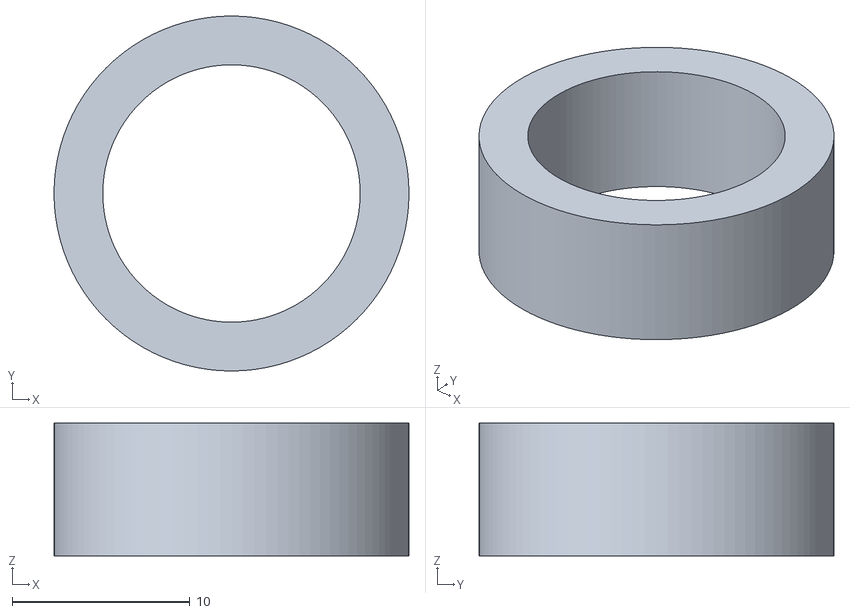
[picture p58: CAD file, 2026-10-17]
version-c-inline-4-improved/print/stl/spacer_O2_O3.stl
20.0 x 20.0 x 7.47
