AmaRamaa/GearBox-Kosova-2027-VR/version-c-inline-4-improved/print/one-plate-70pct/stl/flywheel.stl

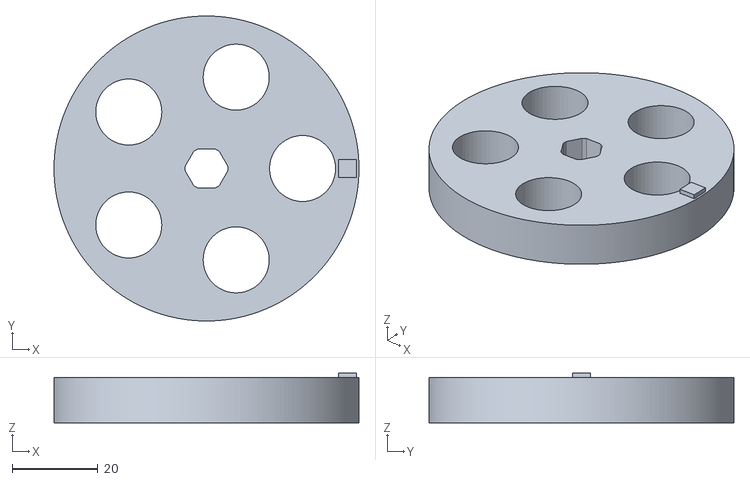
[picture p59: CAD file, 2026-10-18]
version-c-inline-4-improved/print/one-plate-70pct/stl/flywheel.stl
71.1 x 71.1 x 11.6
