AmaRamaa/GearBox-Kosova-2027-VR/version-c-inline-4-improved/print/stl/flywheel.stl

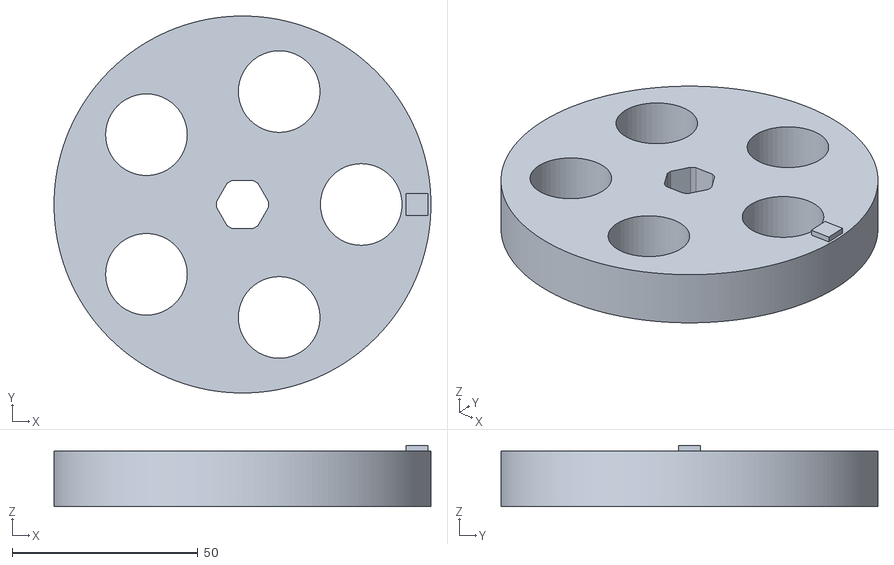
[picture p60: CAD file, 2026-10-17]
version-c-inline-4-improved/print/stl/flywheel.stl
101.6 x 101.6 x 16.5
