AmaRamaa/GearBox-Kosova-2027-VR/version-c-inline-4-improved/print/one-plate-70pct/stl/shaft_O2_O3.stl

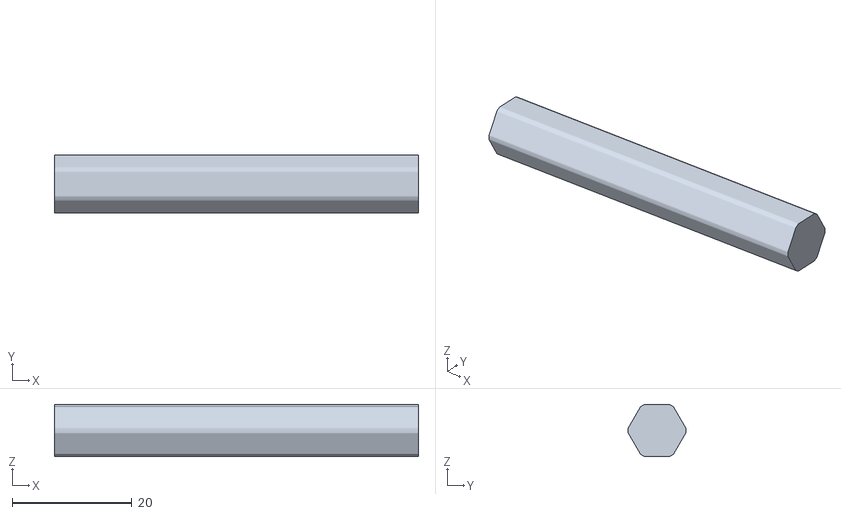
[picture p61: CAD file, 2026-10-18]
version-c-inline-4-improved/print/one-plate-70pct/stl/shaft_O2_O3.stl
60.8 x 9.66 x 8.75
