AmaRamaa/GearBox-Kosova-2027-VR/version-c-inline-4-improved/print/stl/bridge.stl

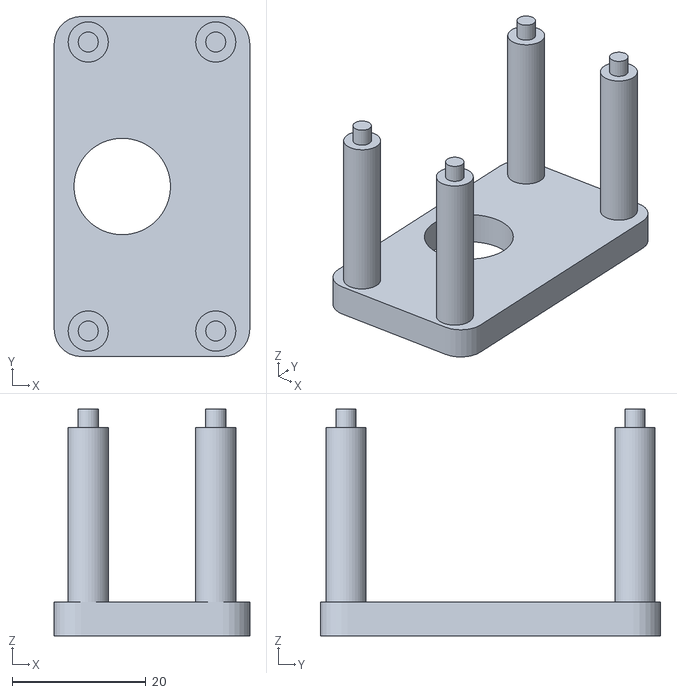
[picture p62: CAD file, 2026-10-17]
version-c-inline-4-improved/print/stl/bridge.stl
29.2 x 50.8 x 33.9
