AmaRamaa/GearBox-Kosova-2027-VR/version-c-inline-4-improved/print/one-plate-70pct/stl/pillar_back.stl

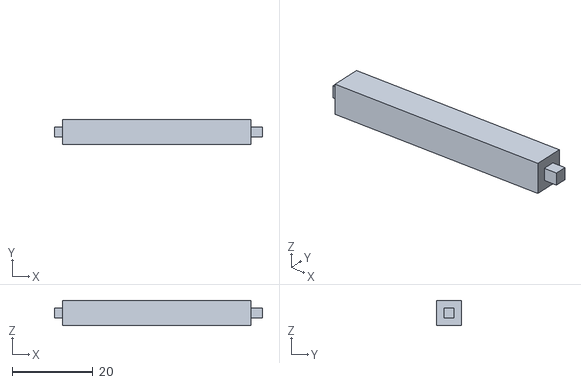
[picture p63: CAD file, 2026-10-18]
version-c-inline-4-improved/print/one-plate-70pct/stl/pillar_back.stl
51.4 x 6.30 x 6.30
