AmaRamaa/GearBox-Kosova-2027-VR/version-c-inline-4-improved/print/stl/pinion_14T.stl

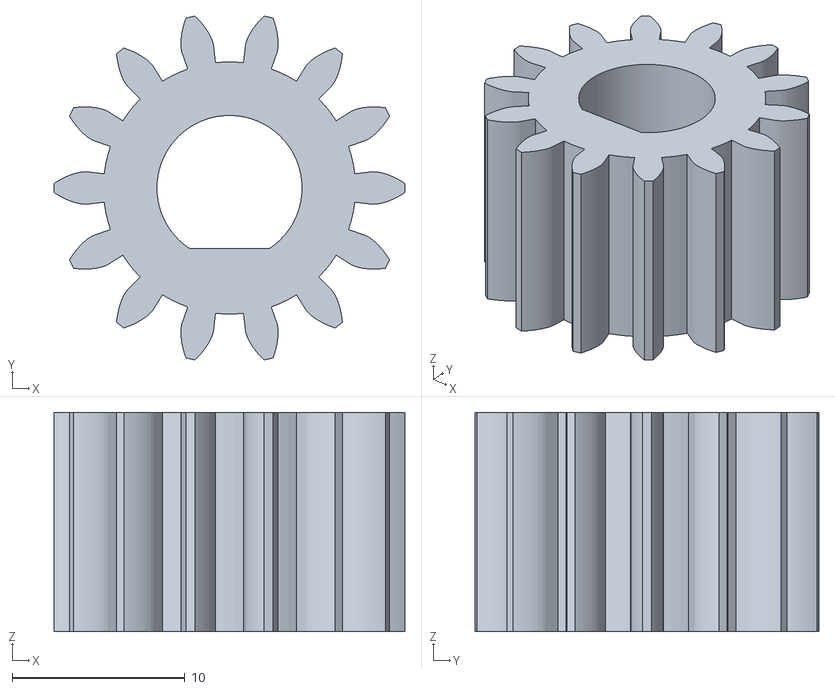
[picture p64: CAD file, 2026-10-17]
version-c-inline-4-improved/print/stl/pinion_14T.stl
20.3 x 19.9 x 12.7
