AmaRamaa/GearBox-Kosova-2027-VR/(list of files, cad)

Other CAD files:
version-c-inline-4-improved/print/one-plate-70pct/stl/belt_ring_TPU.stl
version-c-inline-4-improved/print/one-plate-70pct/stl/shaft_F.stl
version-c-inline-4-improved/print/stl/shaft_ABC.stl
version-c-inline-4-improved/print/stl/belt_ring_TPU.stl
version-c-inline-4-improved/print/one-plate-70pct/stl/washer.stl
version-c-inline-4-improved/print/stl/washer.stl
