AmaRamaa/GearBox-Kosova-2027-VR/version-c-inline-4-improved/print/bed_2_PLA.png

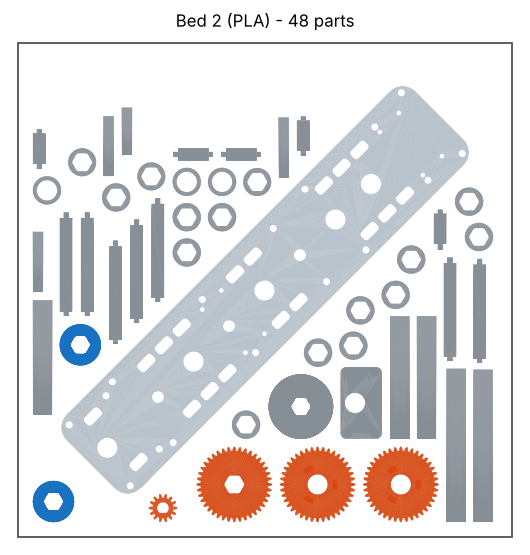
version-c-inline-4-improved/print/bed_2_PLA.png
