AmaRamaa/GearBox-Kosova-2027-VR/version-c-inline-4-improved/print/bed_TPU_belt.png

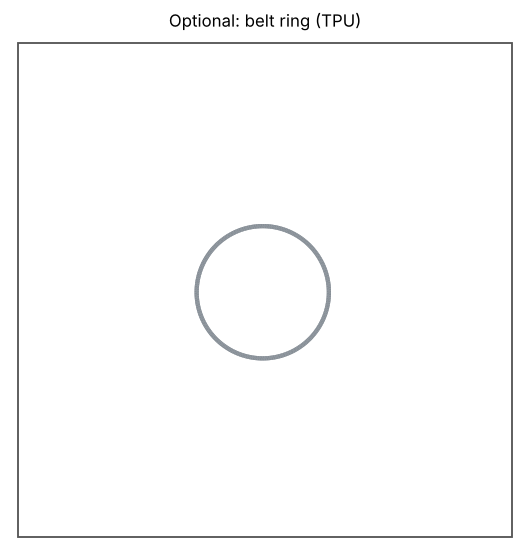
version-c-inline-4-improved/print/bed_TPU_belt.png
