AmaRamaa/GearBox-Kosova-2027-VR/(commit log)

2026-10-17 Add three REV ION shifting gearbox concepts with 3D models
    Version A: 2-output gearbox (flywheel + 2-speed climber), 2 dog collars.
    Version B: flat inline-4 layout with 3 separate outputs.
    Version C: inline-4 with selector-bar interlock, belt-driven 1:1 flywheel,
    bearing bridges, 3-tooth dogs and pocketed plates.
    Claude-Session: https://claude.ai/code/session_018XytbscBm1izWg2o26Zj5n
2026-10-17 Add printable 1:1 hand-cranked model of version C
    - STLs for all 76 parts with real 20DP involute gears
    - Ready-to-slice 3MF beds for a 350 mm printer (Creality K2 Plus)
    - Assembly guide with part positions on each shaft
    - Python sources that generate the parts and run the fit check
    - Flywheel belt pulleys changed to 66T/22T (18T won't fit a 1/2in hex shaft)
    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
    [axle_M1_M3.stl, axle_M4.stl, bed_1_PLA.3mf, bed_2_PLA.3mf, bed_3_PLA.3mf, bed_TPU_belt.3mf, belt_ring_TPU.stl, bridge.stl]
2026-10-17 Add illustrated assembly guide for the printable version C model
    - ASSEMBLY.md: 13 steps, each with a render of the real print parts
    - Parts identification sheet and dimensioned gluing diagram
    - Render scripts in print/source
    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
2026-10-17 Add version D: Hyperdrive, the over-engineered gearbox
    Camshaft shifter with 7 positions, synchronizer cones, 2-speed planetary
    flywheel, flywheel boost, cycloidal 8:1 haul drive, differential climb
    output and a park pawl, as an interactive 3D model.
    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
2026-10-17 Add version E: FGC-kit sliding-gear gearbox
    Built only from FIRST Global REV DUO kit parts plus cut stock: 2 HD Hex
    motors, one sliding 72T gear moved by a Smart Robot Servo, REV plastic
    gears on pillow blocks along 15 mm extrusion. Includes ratios, shaft
    positions, kit parts list and cut list.
    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
2026-10-17 Add version F: FGC dual-differential 4-motor gearbox
    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
2026-10-18 Add 70% one-plate print version of gearbox C
    All 76 PLA parts on one 350 x 350 mm bed. Clearances are compensated so fits
    match the 1:1 model; passes the collision check at all 4 selector positions.
    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
    [axle_M1_M3.stl, axle_M4.stl, bed_TPU_belt_70pct.3mf, bed_one_plate_PLA_70pct.3mf, belt_ring_TPU.stl, bridge.stl, collar.stl, crank_disc.stl]
2026-10-18 Fix gearbox C shifting: tight selector slots, longer collar travel, dog retaining washers
    Selector bar slots were 1.9 mm wider than the fork pegs (more than the collar
    travel), so shifts could leave a dog half engaged. Pegs are now square, slots
    sized to the peg plus 0.2 mm, and collar travel is 3.2 mm at 1:1. Free dog
    gears and the dog pulley could drift into the collars; a glued washer behind
    each now traps them, with the dog lugs moved outward so collars pass around it.
    Applies to the 1:1 beds and the 70% one-plate version (79 parts, still one bed).
    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
    [bed_1_PLA.3mf, bed_2_PLA.3mf, bed_3_PLA.3mf, bed_TPU_belt.3mf, bed_TPU_belt_70pct.3mf, bed_one_plate_PLA_70pct.3mf, collar.stl, fork.stl]
2026-10-18 Add verification reports for the 70% one-plate gearbox C
    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
